chanum/Refri_board_git/documentacion/centrifuga.pdf

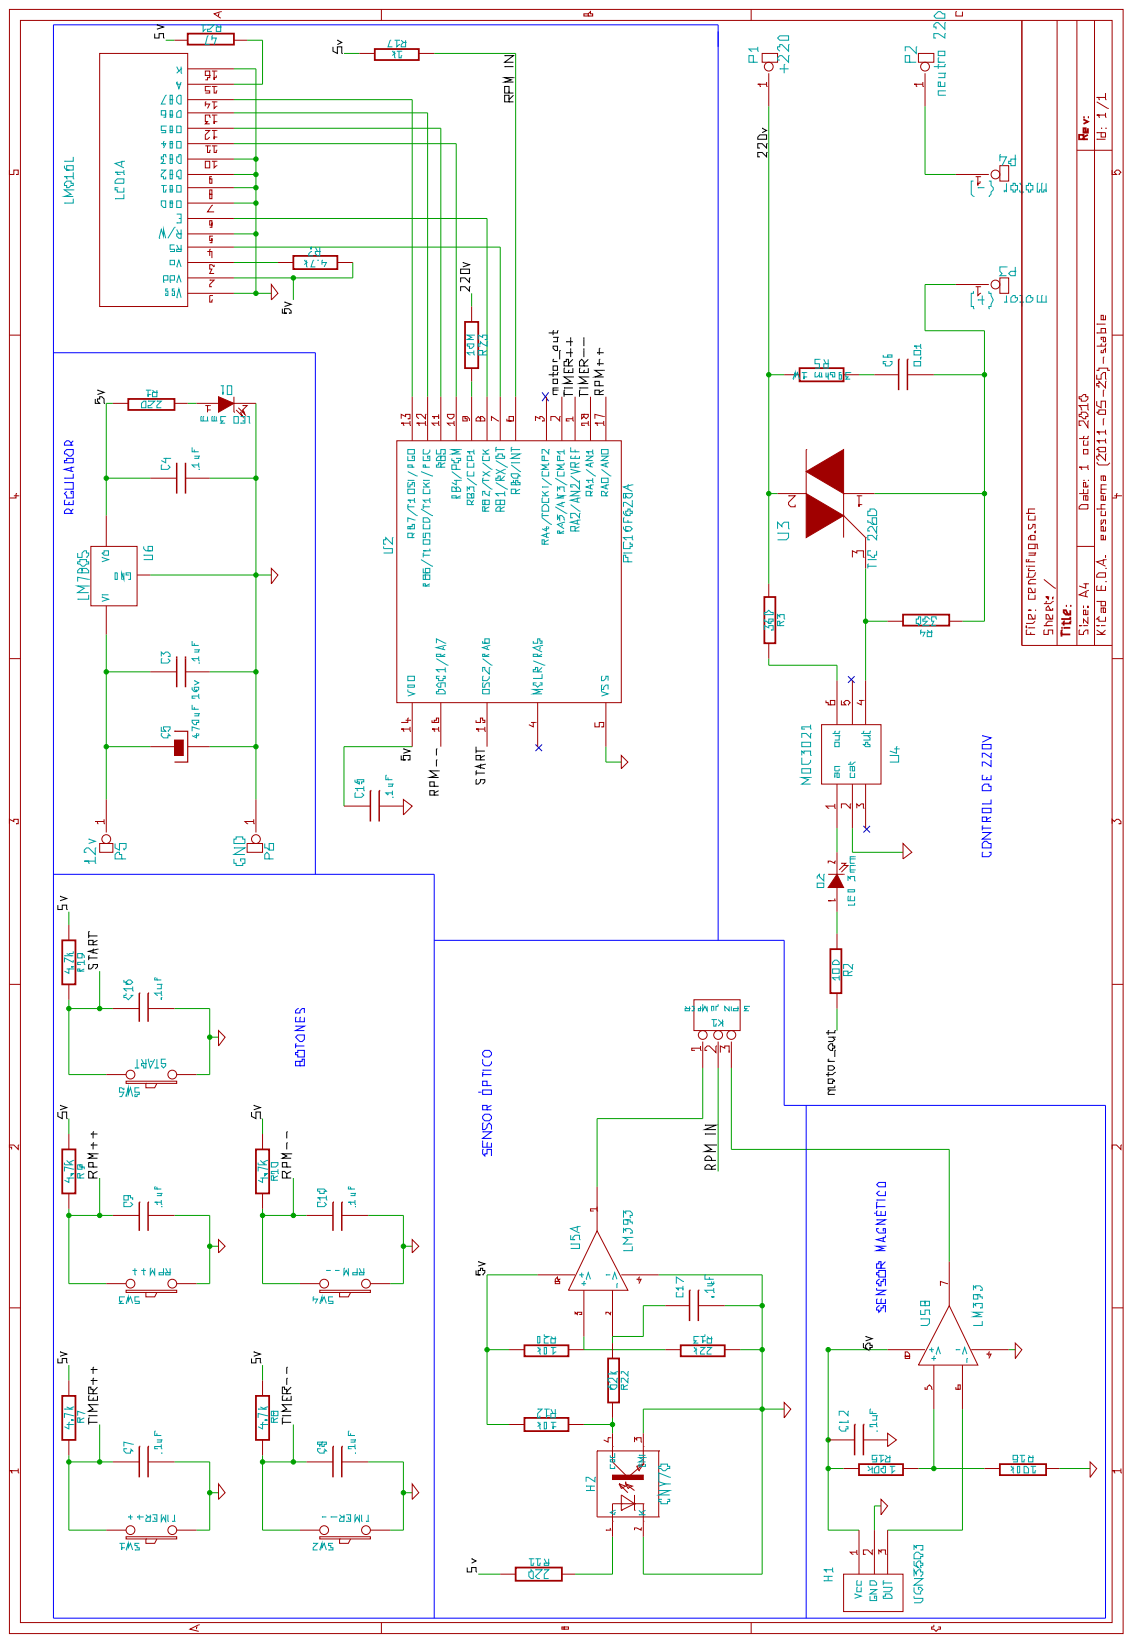
[picture p3: page 1]
