chanum/Refri_board_git/Esquema_PCB_v01/Esquematico.pdf

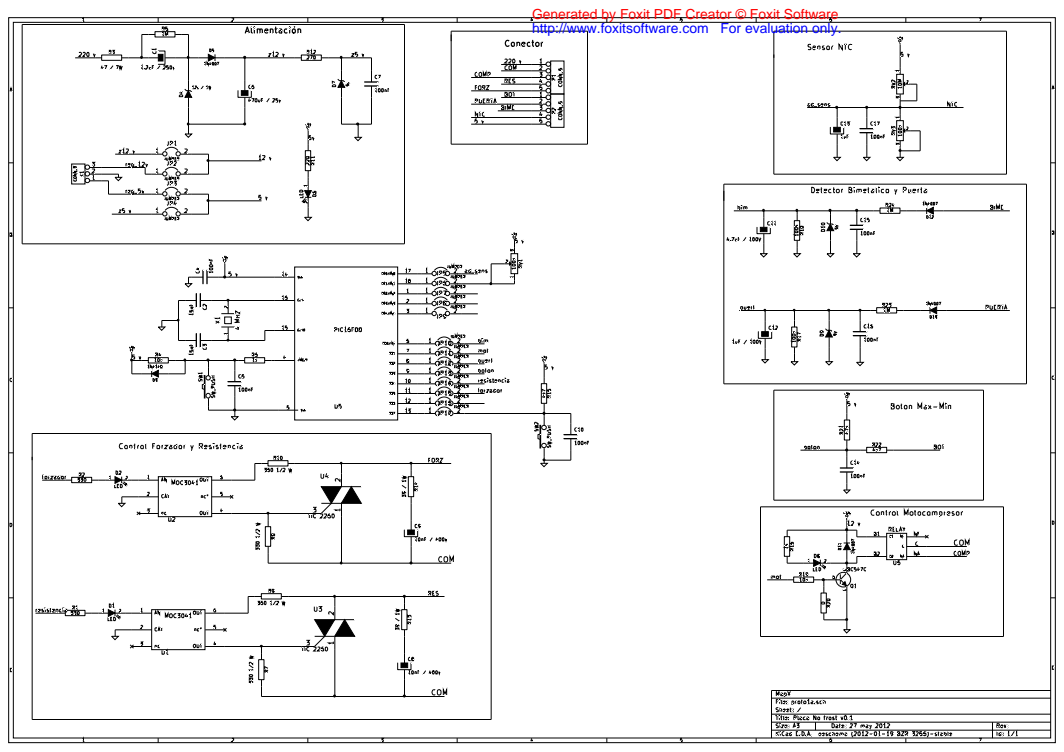
[picture p4: page 1]

Generated by Foxit PDF Creator © Foxit Software
http://www.foxitsoftware.com For evaluation only.
