chanum/Refri_board_git/Esquema_PCB_v01/proto1a.sch

## KiCad design Esquema_PCB_v01/proto1a.sch (2012-10-12, an earlier design)

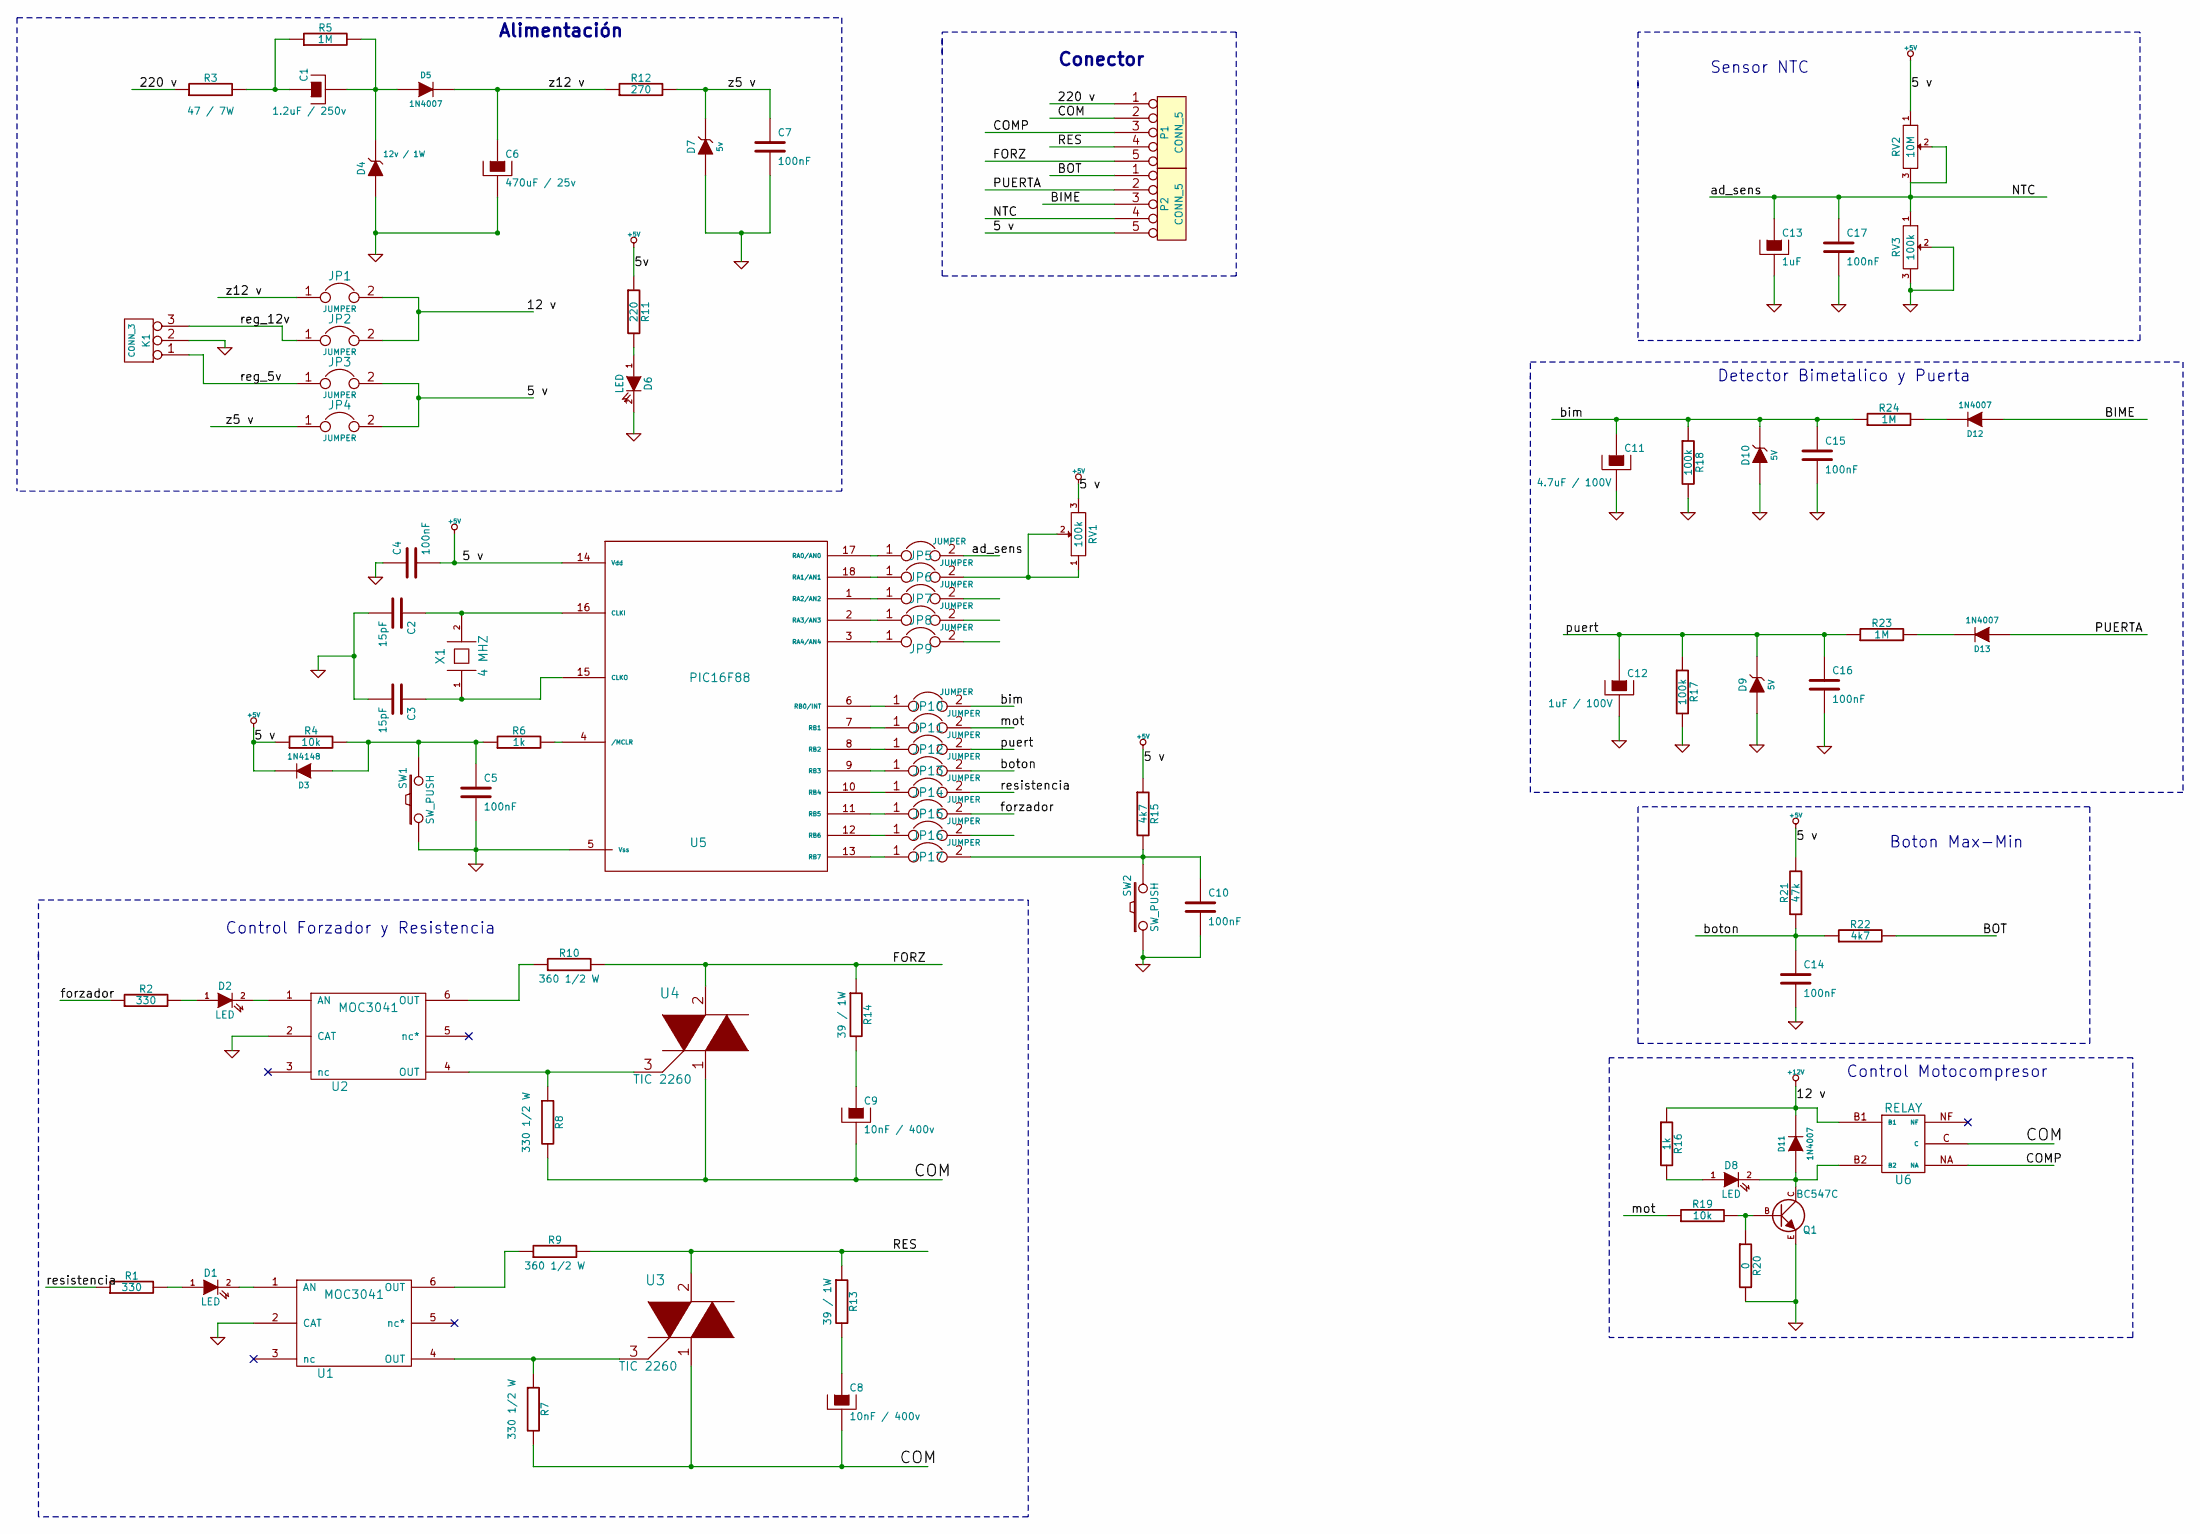
[picture p5: schematic proto1a.sch]

Parts:
C1: 1.2uF / 250v
C2, C3: 15pF
C4, C5, C7, C10, C14, C15, C16, C17: 100nF
C6: 470uF / 25v
C8, C9: 10nF / 400v
C11: 4.7uF / 100V
C12: 1uF / 100V
C13: 1uF
D1, D2, D6, D8: LED
D3: 1N4148
D4: 12v / 1W
D5, D11, D12, D13: 1N4007
D7: 5v
D9, D10: 5V
JP1, JP2, JP3, JP4, JP5, JP6, JP7, JP8, JP9, JP10, JP11, JP12, JP13, JP14, JP15, JP16, JP17: JUMPER
K1: CONN_3
P1, P2: CONN_5
Q1: BC547C; TO92-EBC
R1, R2: 330
R3: 47 / 7W
R4, R19: 10k
R5, R23, R24: 1M
R6, R16: 1k
R7, R8: 330 1/2 W
R9, R10: 360 1/2 W
R11: 220
R12: 270
R13, R14: 39 / 1W
R15, R22: 4k7
R17, R18: 100k
R20: 0
R21: 47k
RV1, RV3: 100k
RV2: 10M
SW1, SW2: SW_PUSH
U1, U2: MOC3041
U3, U4: TIC 2260
U5: PIC16F88
U6: RELAY
X1: 4 MHZ

Connections:
+5V: C4.2, D3.2 (K), JP3.2, JP4.2, P2.5, R4.1, R11.1, R15.1, R21.2, RV1.3, RV2.1, U5.14 (Vdd)
+12V: D11.2 (K), JP1.2, JP2.2, R16.1, U6.B1
BIME: D12.1 (A), P2.3
BOT: P2.1, R22.2
COM: C8.2, C9.2, P1.2, R7.2, R8.2, U3.1, U4.1, U6.C
COMP: P1.3, U6.NA
FORZ: P1.5, R10.2, R14.1, U4.2
GND: C2.2, C3.2, C4.1, C5.2, C6.2, C7.2, C10.2, C11.2, C12.2, C13.2, C14.2, C15.2, C16.2, C17.2, D4.1 (A), D6.2 (K), D7.1 (A), D9.1 (A), D10.1 (A), K1.2 (PM), Q1.E, R17.2, R18.2, R20.2, RV3.2, RV3.3, SW1.1, SW2.1, U1.2 (CAT), U2.2 (CAT), U5.5 (Vss)
unnamed: C1.1, R3.2, R5.1
unnamed: C1.2, D4.2 (K), D5.1 (A), R5.2
unnamed: C2.1, U5.16 (CLKI), X1.2
unnamed: C3.1, U5.15 (CLKO), X1.1
unnamed: C5.1, D3.1 (A), R4.2, R6.1, SW1.2
unnamed: C8.1, R13.2
unnamed: C9.1, R14.2
unnamed: C10.1, JP17.2, R15.2, SW2.2
unnamed: D1.1 (A), R1.2
unnamed: D1.2 (K), U1.1 (AN)
unnamed: D2.1 (A), R2.2
unnamed: D2.2 (K), U2.1 (AN)
unnamed: D6.1 (A), R11.2
unnamed: D8.1 (A), R16.2
unnamed: D8.2 (K), D11.1 (A), Q1.C, U6.B2
unnamed: D12.2 (K), R24.2
unnamed: D13.2 (K), R23.2
unnamed: JP5.1, U5.17 (RA0/AN0)
unnamed: JP6.1, U5.18 (RA1/AN1)
unnamed: JP6.2, RV1.1, RV1.2
unnamed: JP7.1, U5.1 (RA2/AN2)
unnamed: JP8.1, U5.2 (RA3/AN3)
unnamed: JP9.1, U5.3 (RA4/AN4)
unnamed: JP10.1, U5.6 (RB0/INT)
unnamed: JP11.1, U5.7 (RB1)
unnamed: JP12.1, U5.8 (RB2)
unnamed: JP13.1, U5.9 (RB3)
unnamed: JP14.1, U5.10 (RB4)
unnamed: JP15.1, U5.11 (RB5)
unnamed: JP16.1, U5.12 (RB6)
unnamed: JP17.1, U5.13 (RB7)
unnamed: Q1.B, R19.2, R20.1
unnamed: R6.2, U5.4 (/MCLR)
unnamed: R7.1, U1.4 (OUT), U3.3
unnamed: R8.1, U2.4 (OUT), U4.3
unnamed: R9.1, U1.6 (OUT)
unnamed: R10.1, U2.6 (OUT)
PUERTA: D13.1 (A), P2.2
RES: P1.4, R9.2, R13.1, U3.2
ad_sens: C13.1, C17.1, JP5.2, P2.4, RV2.2, RV2.3, RV3.1
bim: C11.1, C15.1, D10.2 (K), JP10.2, R18.1, R24.1
boton: C14.1, JP13.2, R21.1, R22.1
forzador: JP15.2, R2.1
mot: JP11.2, R19.1
puert: C12.1, C16.1, D9.2 (K), JP12.2, R17.1, R23.1
reg_5v: JP3.1, K1.1
reg_12v: JP2.1, K1.3
resistencia: JP14.2, R1.1
v: P1.1, R3.1
z5 v: C7.1, D7.2 (K), JP4.1, R12.2
z12 v: C6.1, D5.2 (K), JP1.1, R12.1

Notes on the sheet:
Control Forzador y Resistencia
Sensor NTC
Detector Bimetalico y Puerta
Boton Max-Min
Control Motocompresor
Conector
Alimentación
