chanum/Refri_board_git/Esquema_PCB_v02/proto2a.sch

## KiCad design Esquema_PCB_v02/proto2a.sch (2012-10-26)

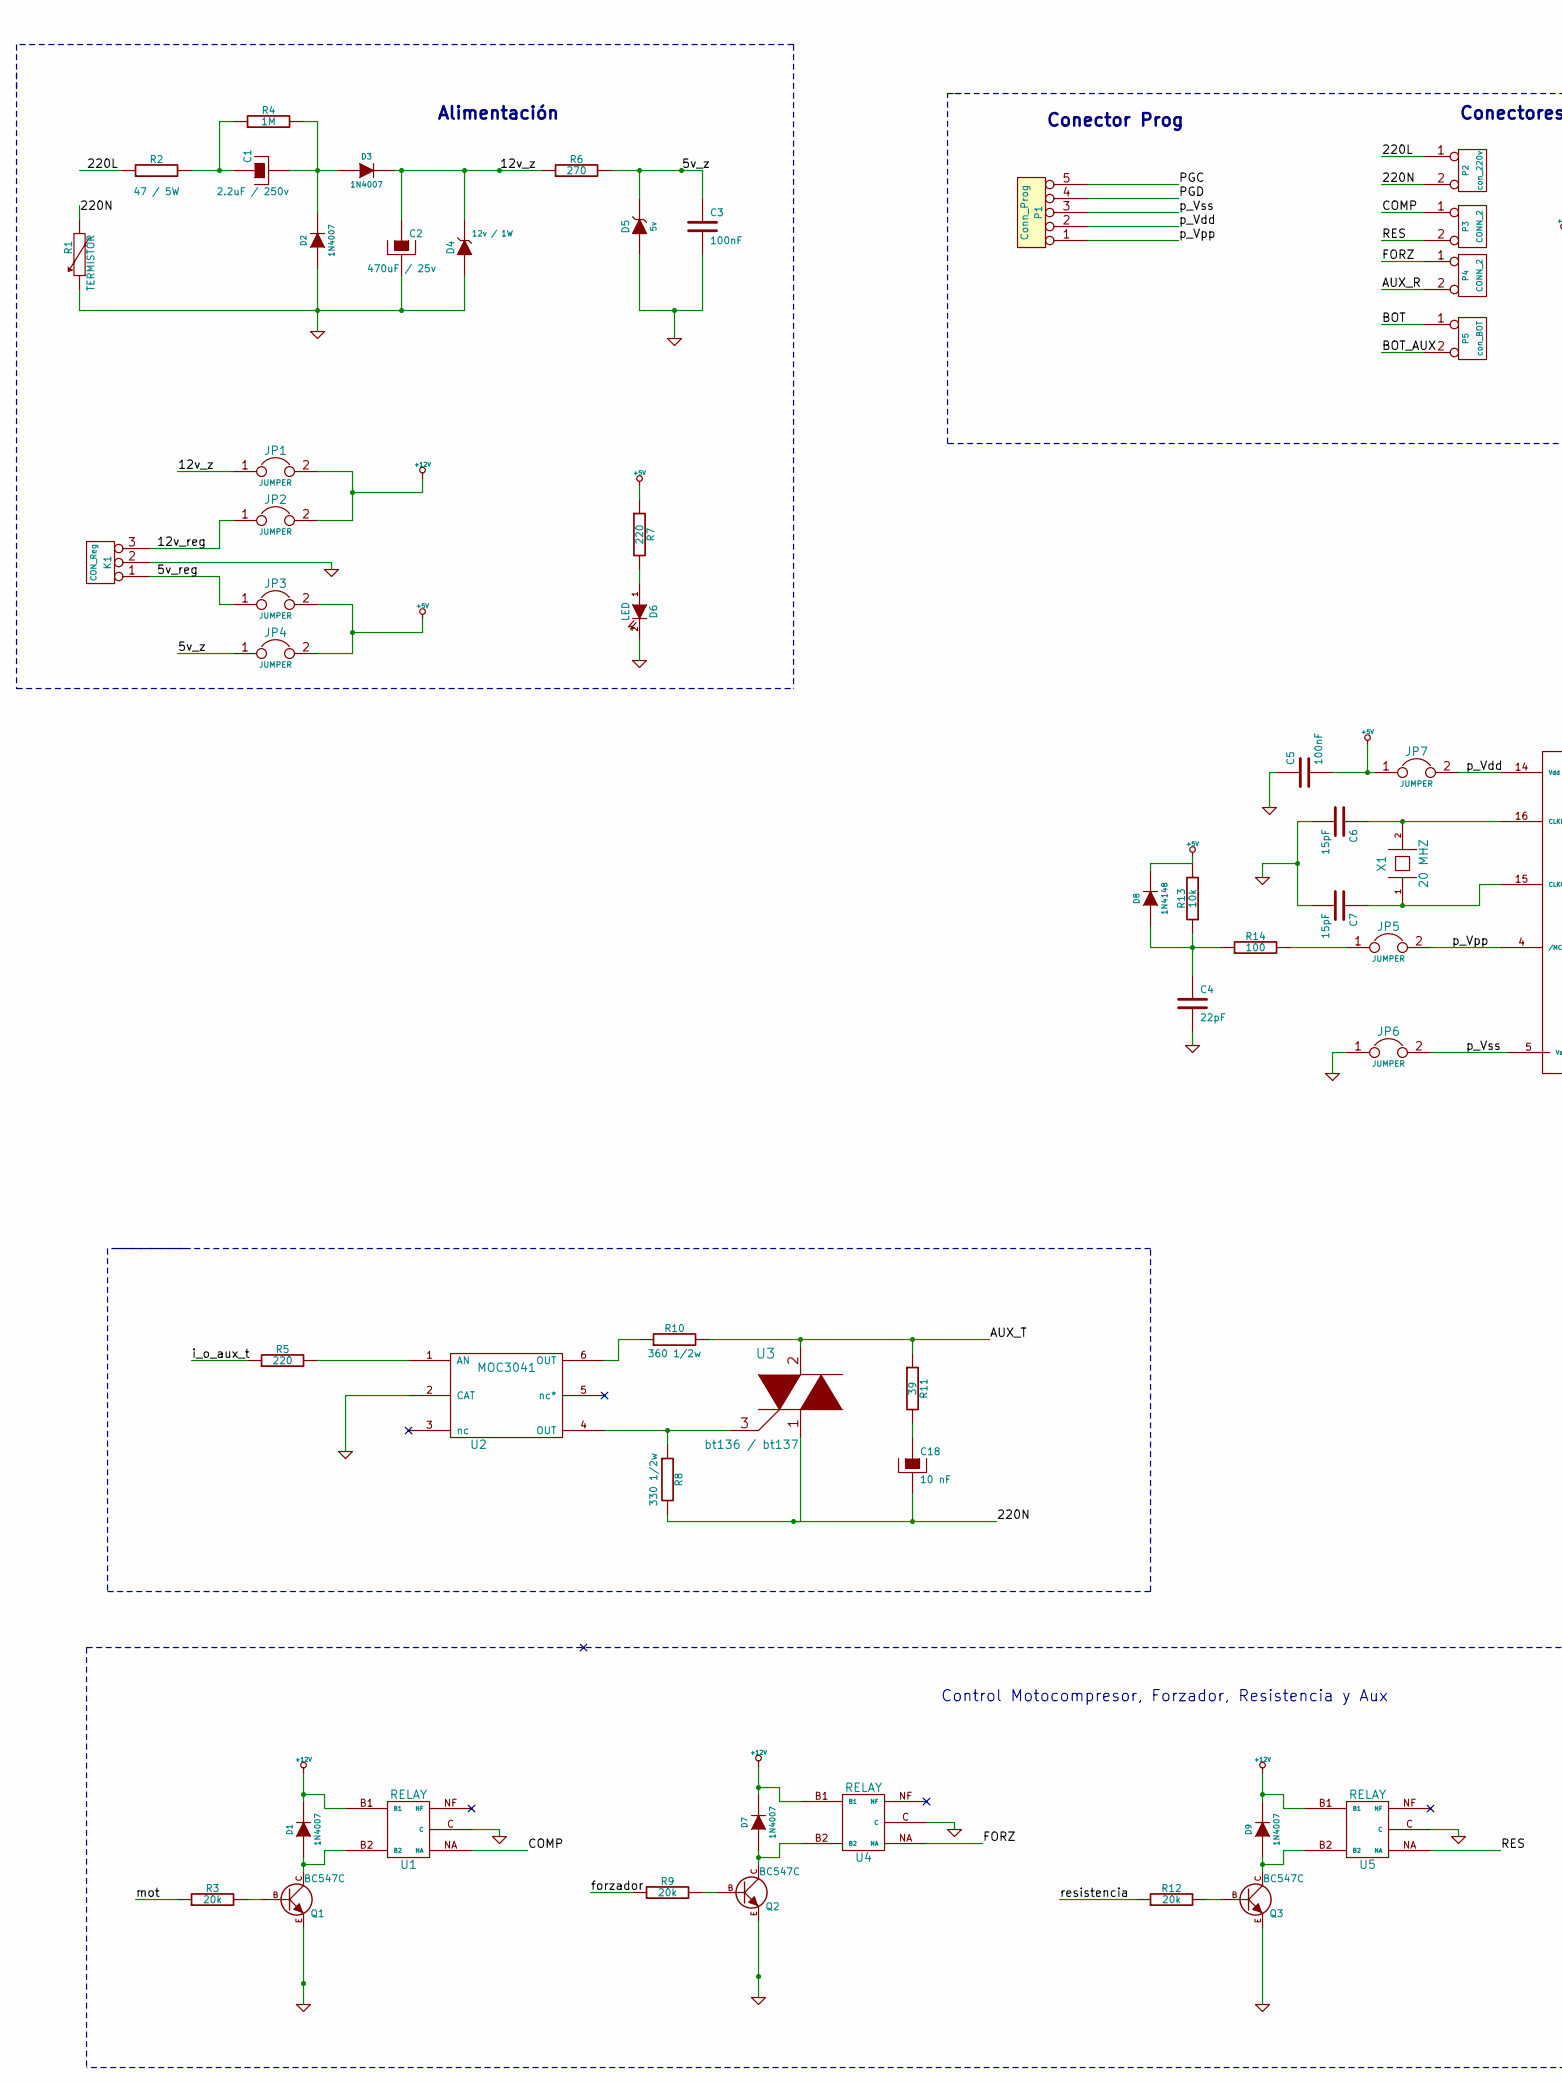
[picture p6: schematic proto2a.sch, part in row 1, column 1]

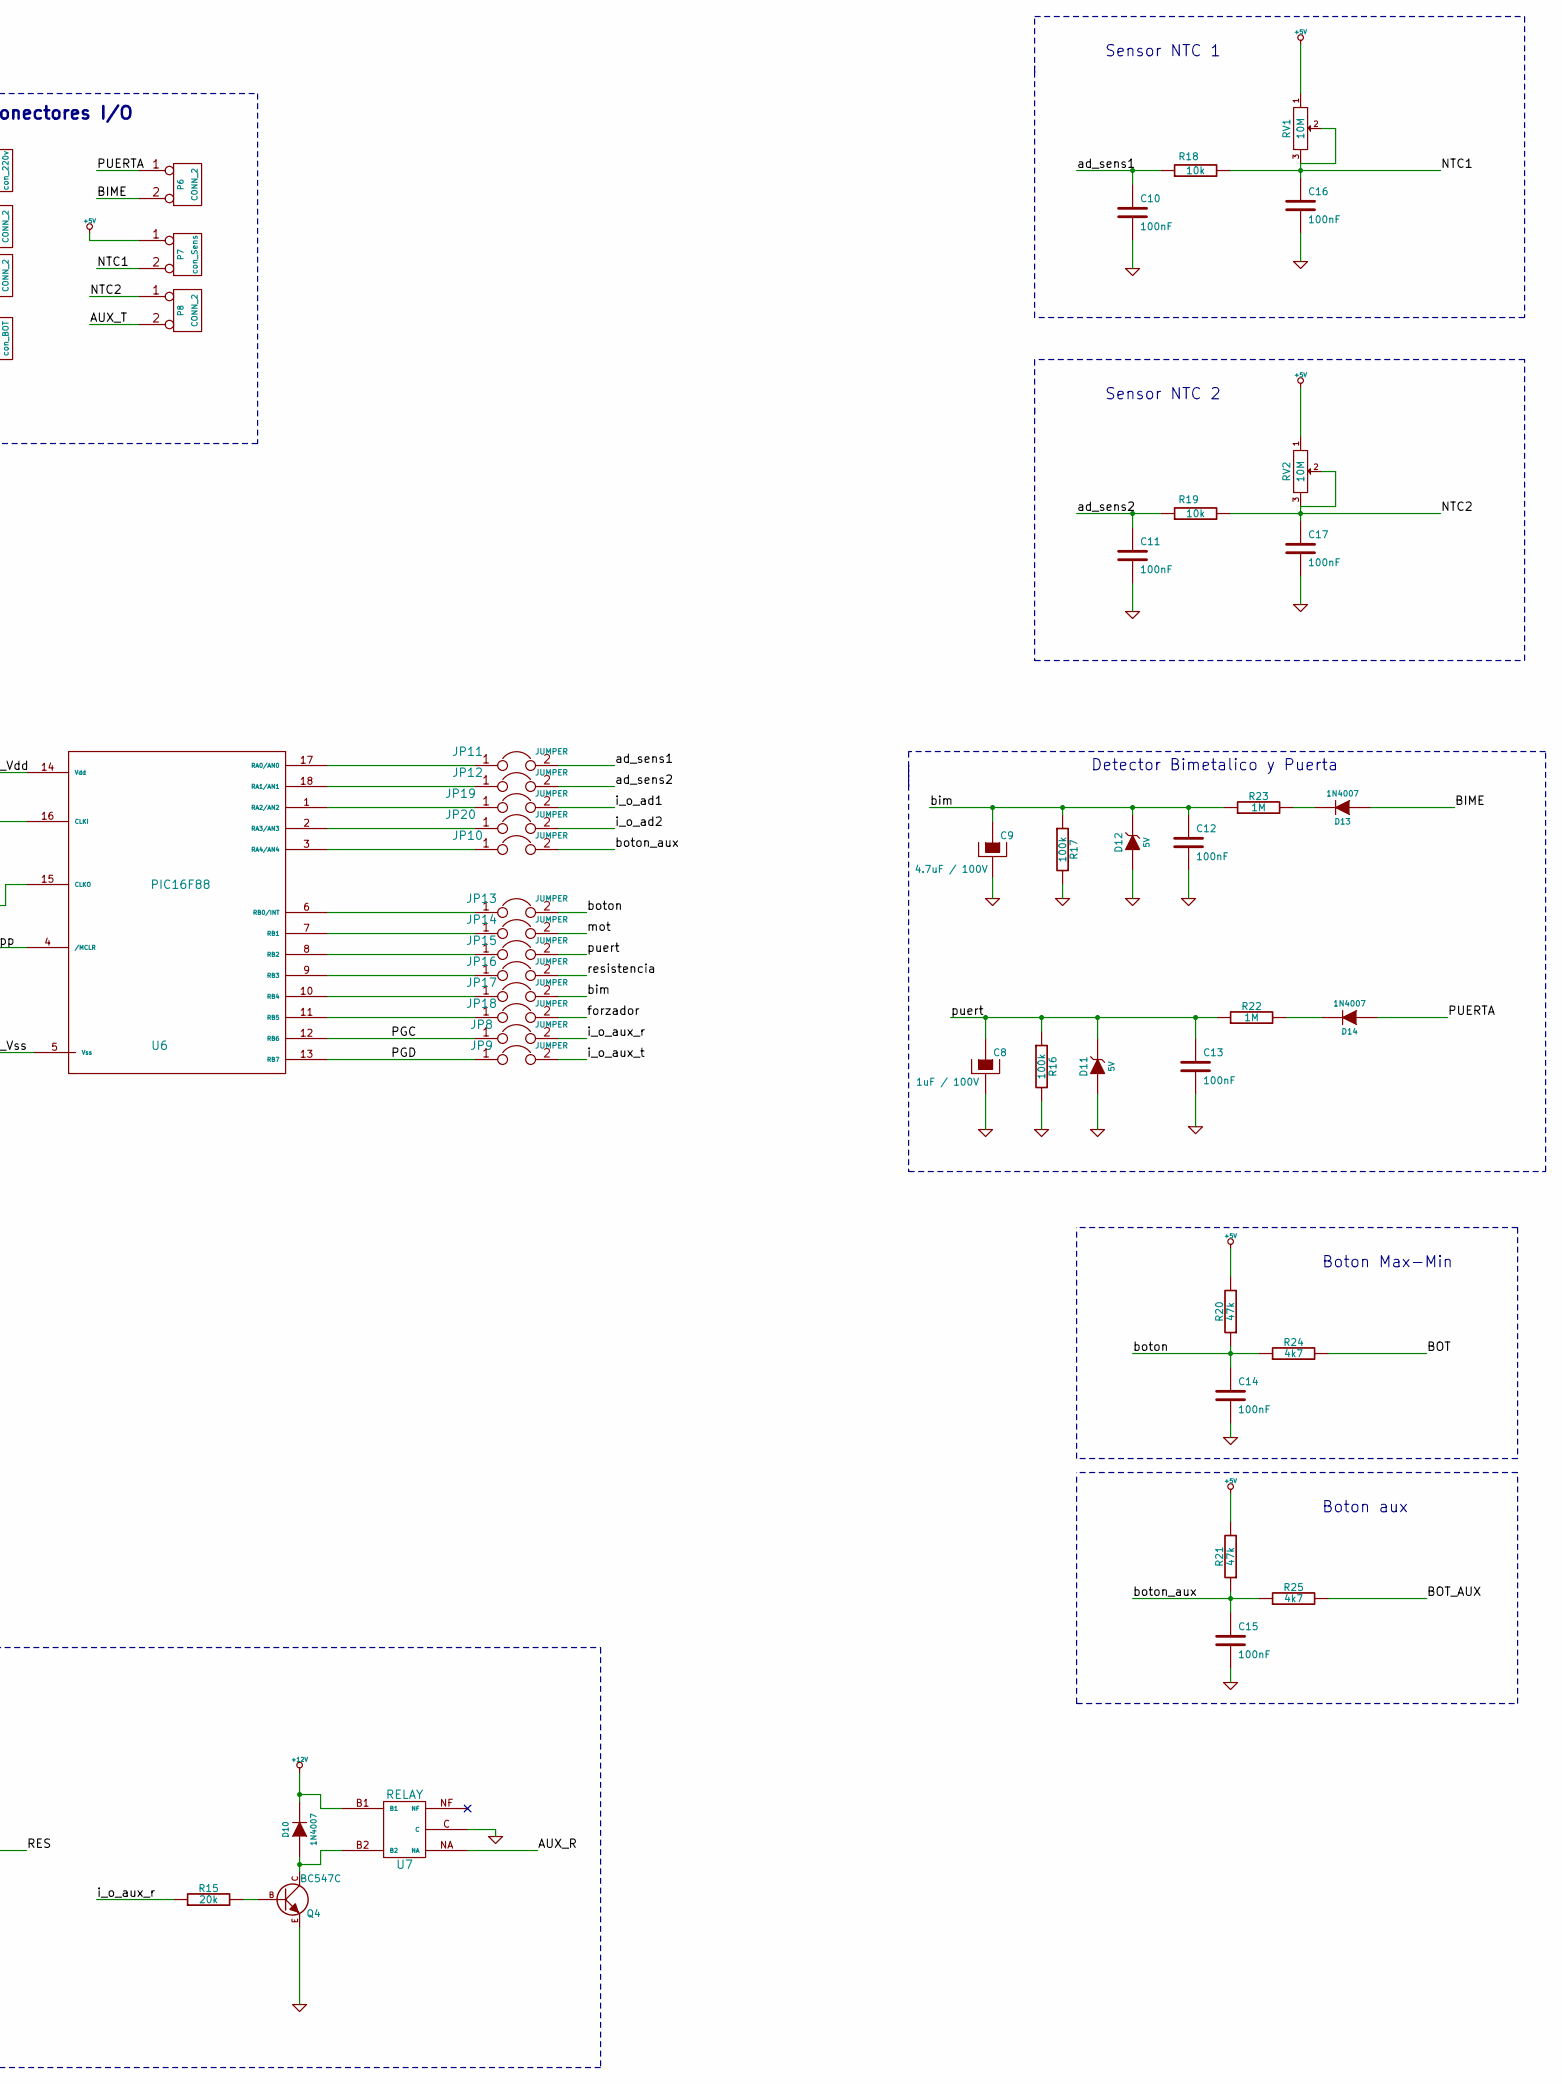
[picture p7: schematic proto2a.sch, part in row 1, column 2]

Parts:
C1: 2.2uF / 250v
C2: 470uF / 25v
C3, C5, C10, C11, C12, C13, C14, C15, C16, C17: 100nF
C4: 22pF
C6, C7: 15pF
C8: 1uF / 100V
C9: 4.7uF / 100V
C18: 10 nF
D1, D2, D3, D7, D9, D10, D13, D14: 1N4007
D4: 12v / 1W
D5: 5v
D6: LED
D8: 1N4148
D11, D12: 5V
JP1, JP2, JP3, JP4, JP5, JP6, JP7, JP8, JP9, JP10, JP11, JP12, JP13, JP14, JP15, JP16, JP17, JP18, JP19, JP20: JUMPER
K1: CON_Reg
P1: Conn_Prog
P2: con_220v
P3, P4, P6, P8: CONN_2
P5: con_BOT
P7: con_Sens
Q1, Q2, Q3, Q4: BC547C; TO92-EBC
R1: TERMISTOR
R2: 47 / 5W
R3, R9, R12, R15: 20k
R4, R22, R23: 1M
R5, R7: 220
R6: 270
R8: 330 1/2w
R10: 360 1/2w
R11: 39
R13, R18, R19: 10k
R14: 100
R16, R17: 100k
R20, R21: 47k
R24, R25: 4k7
RV1, RV2: 10M
U1, U4, U5, U7: RELAY
U2: MOC3041
U3: bt136 / bt137
U6: PIC16F88
X1: 20 MHZ

Connections:
5v_reg: JP3.1, K1.1
5v_z: C3.1, D5.2 (K), JP4.1, R6.2
12v_reg: JP2.1, K1.3
12v_z: C2.1, D3.2 (K), D4.2 (K), JP1.1, R6.1
220L: P2.1, R2.1
220N: C18.2, P2.2 (PM), R1.2, R8.2, U3.1
+5V: C5.2, D8.2 (K), JP3.2, JP4.2, JP7.1, P7.1, R7.1, R13.2, R20.2, R21.2, RV1.1, RV2.1
+12V: D1.2 (K), D7.2 (K), D9.2 (K), D10.2 (K), JP1.2, JP2.2, U1.B1, U4.B1, U5.B1, U7.B1
AUX_R: P4.2 (PM), U7.NA
AUX_T: P8.2 (PM), R10.2, R11.1, U3.2
BIME: D13.1 (A), P6.2 (PM)
BOT: P5.1, R24.2
BOT_AUX: P5.2 (PM), R25.2
COMP: P3.1, U1.NA
FORZ: P4.1, U4.NA
GND: C2.2, C3.2, C4.2, C5.1, C6.2, C7.2, C8.2, C9.2, C10.2, C11.2, C12.2, C13.2, C14.2, C15.2, C16.2, C17.2, D2.1 (A), D4.1 (A), D5.1 (A), D6.2 (K), D11.1 (A), D12.1 (A), JP6.1, K1.2 (PM), Q1.E, Q2.E, Q3.E, Q4.E, R1.1, R16.2, R17.2, U1.C, U2.2 (CAT), U4.C, U5.C, U7.C
NTC1: C16.1, P7.2 (PM), R18.2, RV1.2, RV1.3
NTC2: C17.1, P8.1, R19.2, RV2.2, RV2.3
unnamed: C1.1, R2.2, R4.1
unnamed: C1.2, D2.2 (K), D3.1 (A), R4.2
unnamed: C4.1, D8.1 (A), R13.1, R14.1
unnamed: C6.1, U6.16 (CLKI), X1.2
unnamed: C7.1, U6.15 (CLKO), X1.1
unnamed: C18.1, R11.2
unnamed: D1.1 (A), Q1.C, U1.B2
unnamed: D6.1 (A), R7.2
unnamed: D7.1 (A), Q2.C, U4.B2
unnamed: D9.1 (A), Q3.C, U5.B2
unnamed: D10.1 (A), Q4.C, U7.B2
unnamed: D13.2 (K), R23.2
unnamed: D14.2 (K), R22.2
unnamed: JP5.1, R14.2
unnamed: JP10.1, U6.3 (RA4/AN4)
unnamed: JP11.1, U6.17 (RA0/AN0)
unnamed: JP12.1, U6.18 (RA1/AN1)
unnamed: JP13.1, U6.6 (RB0/INT)
unnamed: JP14.1, U6.7 (RB1)
unnamed: JP15.1, U6.8 (RB2)
unnamed: JP16.1, U6.9 (RB3)
unnamed: JP17.1, U6.10 (RB4)
unnamed: JP18.1, U6.11 (RB5)
unnamed: JP19.1, U6.1 (RA2/AN2)
unnamed: JP20.1, U6.2 (RA3/AN3)
unnamed: Q1.B, R3.2
unnamed: Q2.B, R9.2
unnamed: Q3.B, R12.2
unnamed: Q4.B, R15.2
unnamed: R5.2, U2.1 (AN)
unnamed: R8.1, U2.4 (OUT), U3.3
unnamed: R10.1, U2.6 (OUT)
PGC: JP8.1, P1.5, U6.12 (RB6)
PGD: JP9.1, P1.4, U6.13 (RB7)
PUERTA: D14.1 (A), P6.1
RES: P3.2 (PM), U5.NA
ad_sens1: C10.1, JP11.2, R18.1
ad_sens2: C11.1, JP12.2, R19.1
bim: C9.1, C12.1, D12.2 (K), JP17.2, R17.1, R23.1
boton: C14.1, JP13.2, R20.1, R24.1
boton_aux: C15.1, JP10.2, R21.1, R25.1
forzador: JP18.2, R9.1
i_o_ad1: JP19.2
i_o_ad2: JP20.2
i_o_aux_r: JP8.2, R15.1
i_o_aux_t: JP9.2, R5.1
mot: JP14.2, R3.1
p_Vdd: JP7.2, P1.2, U6.14 (Vdd)
p_Vpp: JP5.2, P1.1, U6.4 (/MCLR)
p_Vss: JP6.2, P1.3, U6.5 (Vss)
puert: C8.1, C13.1, D11.2 (K), JP15.2, R16.1, R22.1
resistencia: JP16.2, R12.1

Notes on the sheet:
Conector Prog
Boton aux
Sensor NTC 2
Control Motocompresor, Forzador, Resistencia y Aux
Sensor NTC 1
Detector Bimetalico y Puerta
Boton Max-Min
Conectores I/O
Alimentación
