chanum/Refri_board_git/(commit log)

2012-10-12 Primer Commit
    [proto1a.brd, proto1a.sch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]
2012-10-23 Agregado de la version 2
    [proto1a.brd, proto1a.sch, proto2a.sch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]
2012-10-26 Netlis y pcb01
    [proto1a.brd, proto1a.sch, proto2a.sch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]
2012-10-26 Netlis y pcb02
    [proto2a.brd]
